aks4896/GalvoInterface/design/block_diagram.pdf

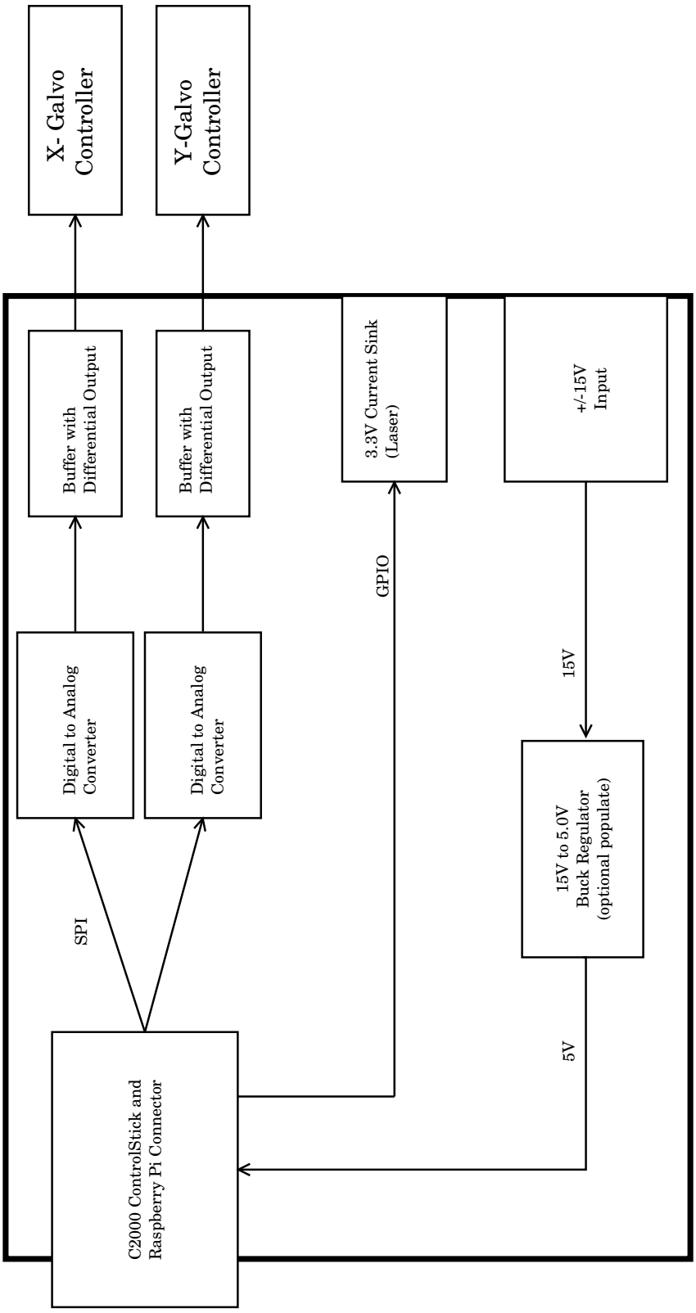
[picture p1: figure]
X- Galvo; Controller; Y-Galvo; Digital to Analog; Converter; Buffer with; Differential Output; C2000 ControlStick and Raspberry Pi Connector; SPI; 3.3V Current Sink; (Laser) GPIO; +/-15V Input; Buck Regulator; (optional populate)

# Differential Output Digital to Analog Converter

Alex Sojda

Galvo Interface Block Diagram V0.1

http://alex.sojda.org/blog
alex.sojda@gmail.com
