aks4896/GalvoInterface/Interface HW.pdf

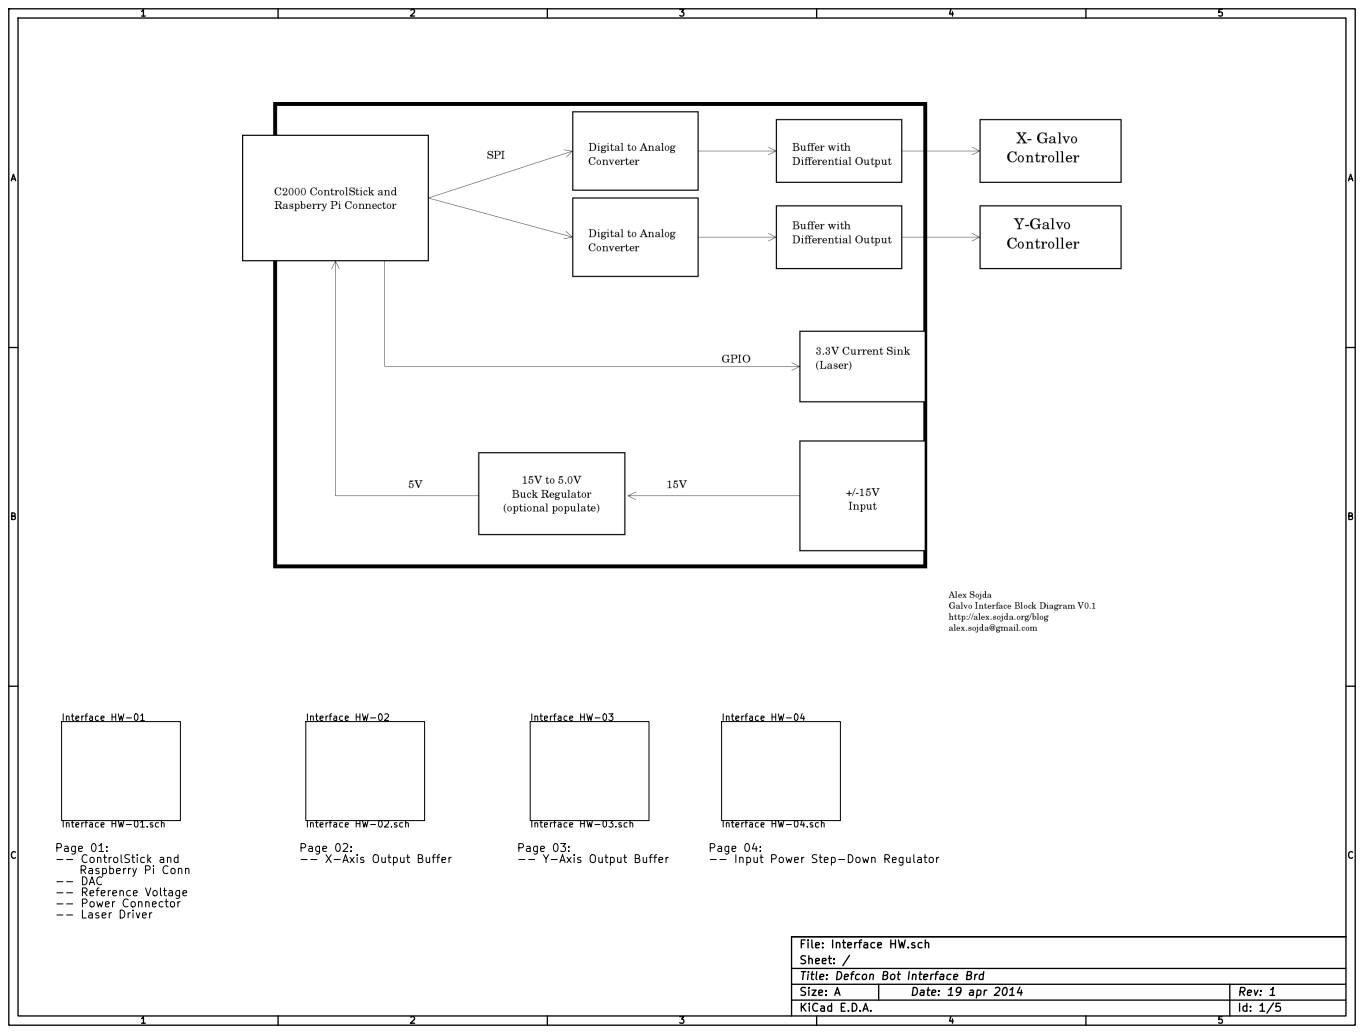
[picture p3: page 1]

Interface HW-03.sch Page 01:

Interface HW-04.sch Page 04:

-- Input Power Step-Down Regulator

Id: 1/5 Title: Defcon Bot Interface Brd File: Interface HW.sch Sheet: /

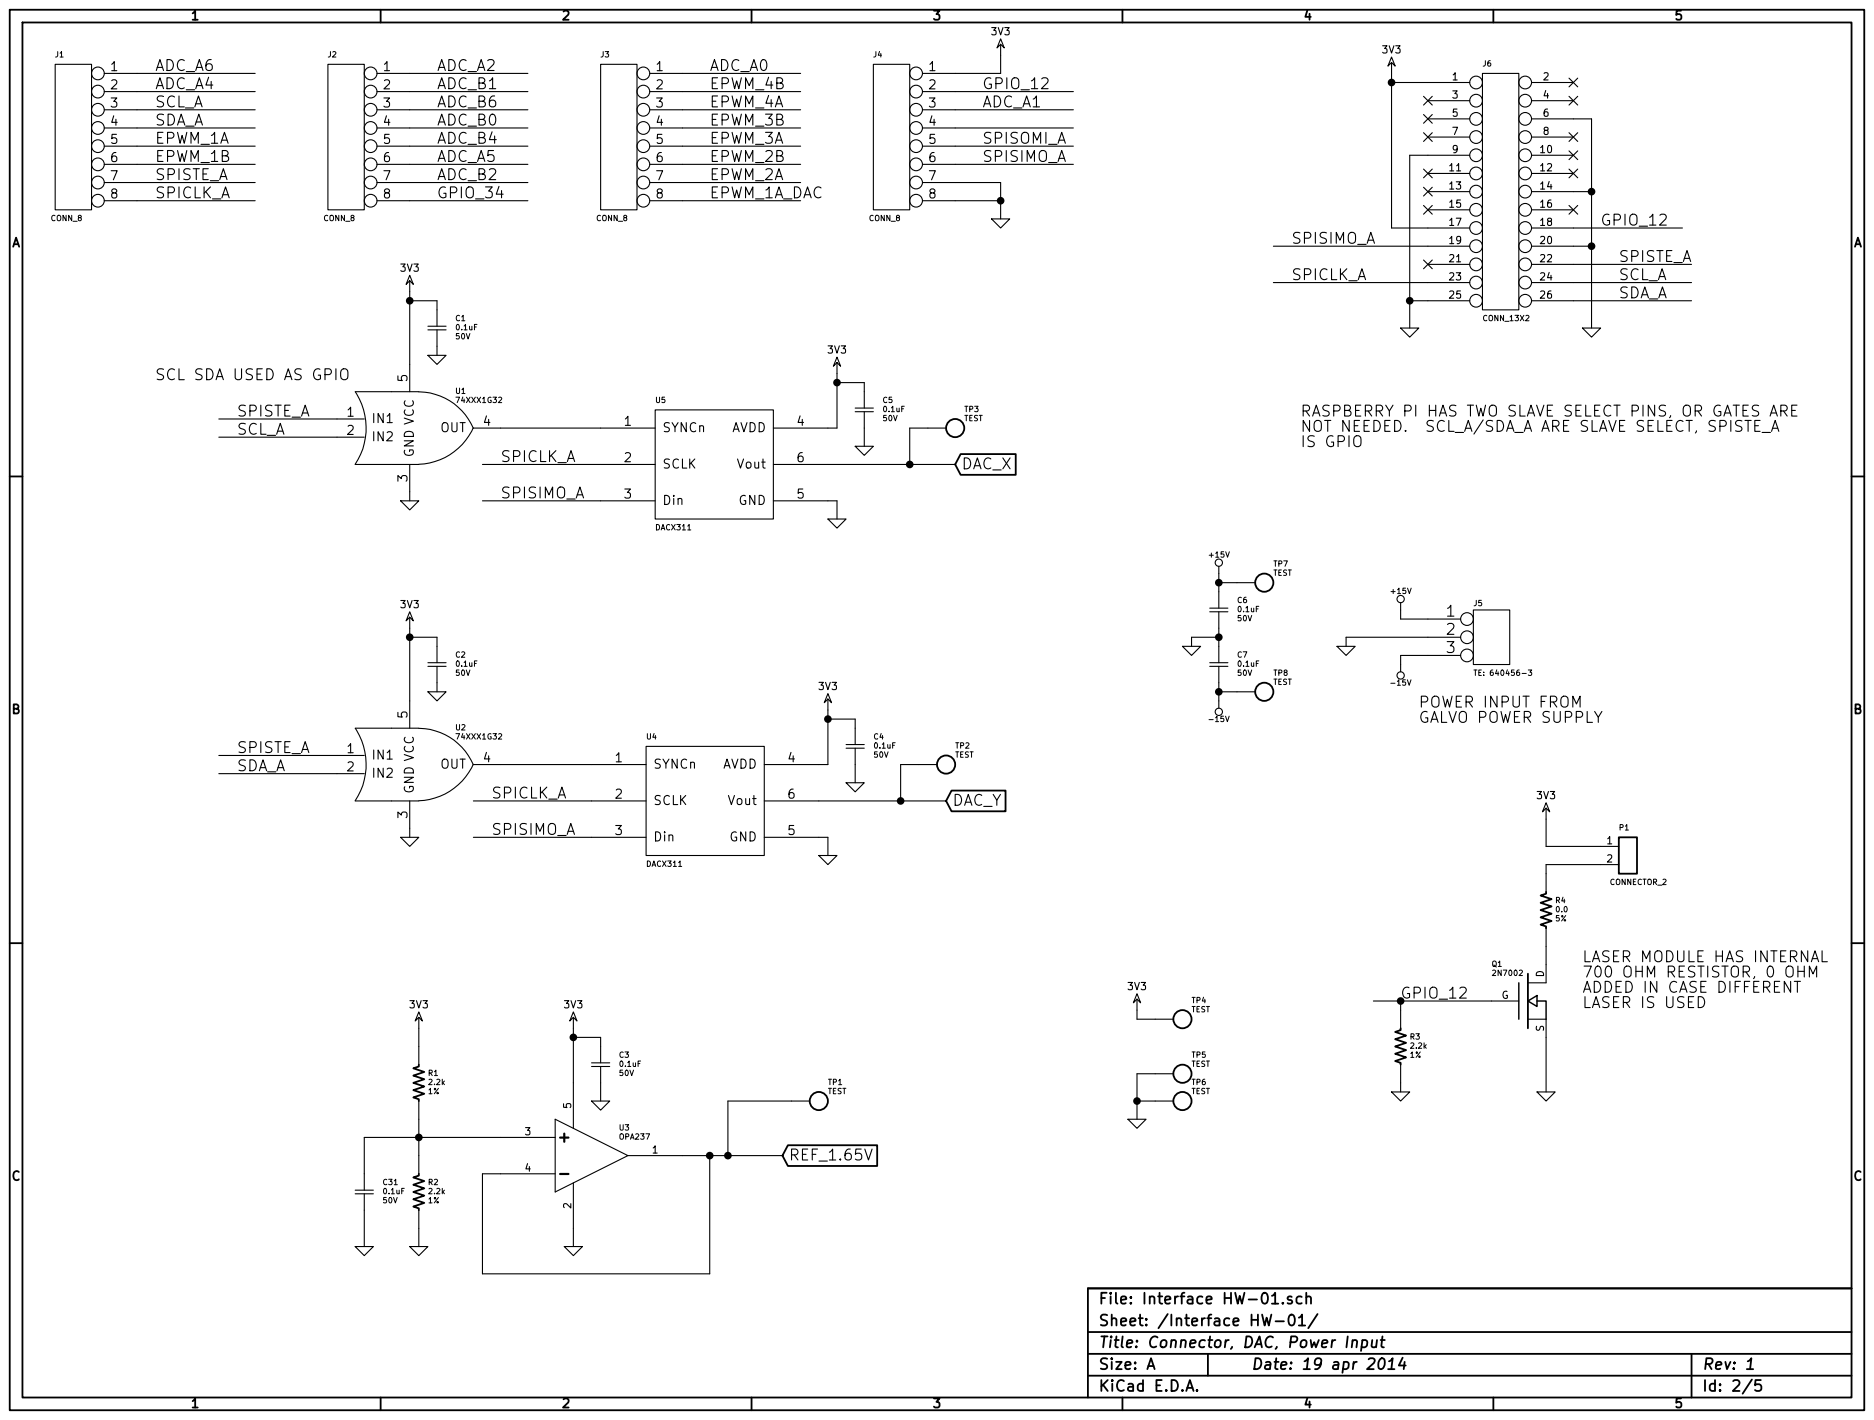
[picture p4: page 2]

SCL SDA USED AS GPIO

RASPBERRY PI HAS TWO SLAVE SELECT PINS, OR GATES ARE
NOT NEEDED. SCL_A/SDA_A ARE SLAVE SELECT, SPISTE_A
IS GPIO

700 OHM RESTISTOR, 0 OHM
ADDED IN CASE DIFFERENT

Title: Connector, DAC, Power Input File: Interface HW-01.sch Sheet: /Interface HW-01/

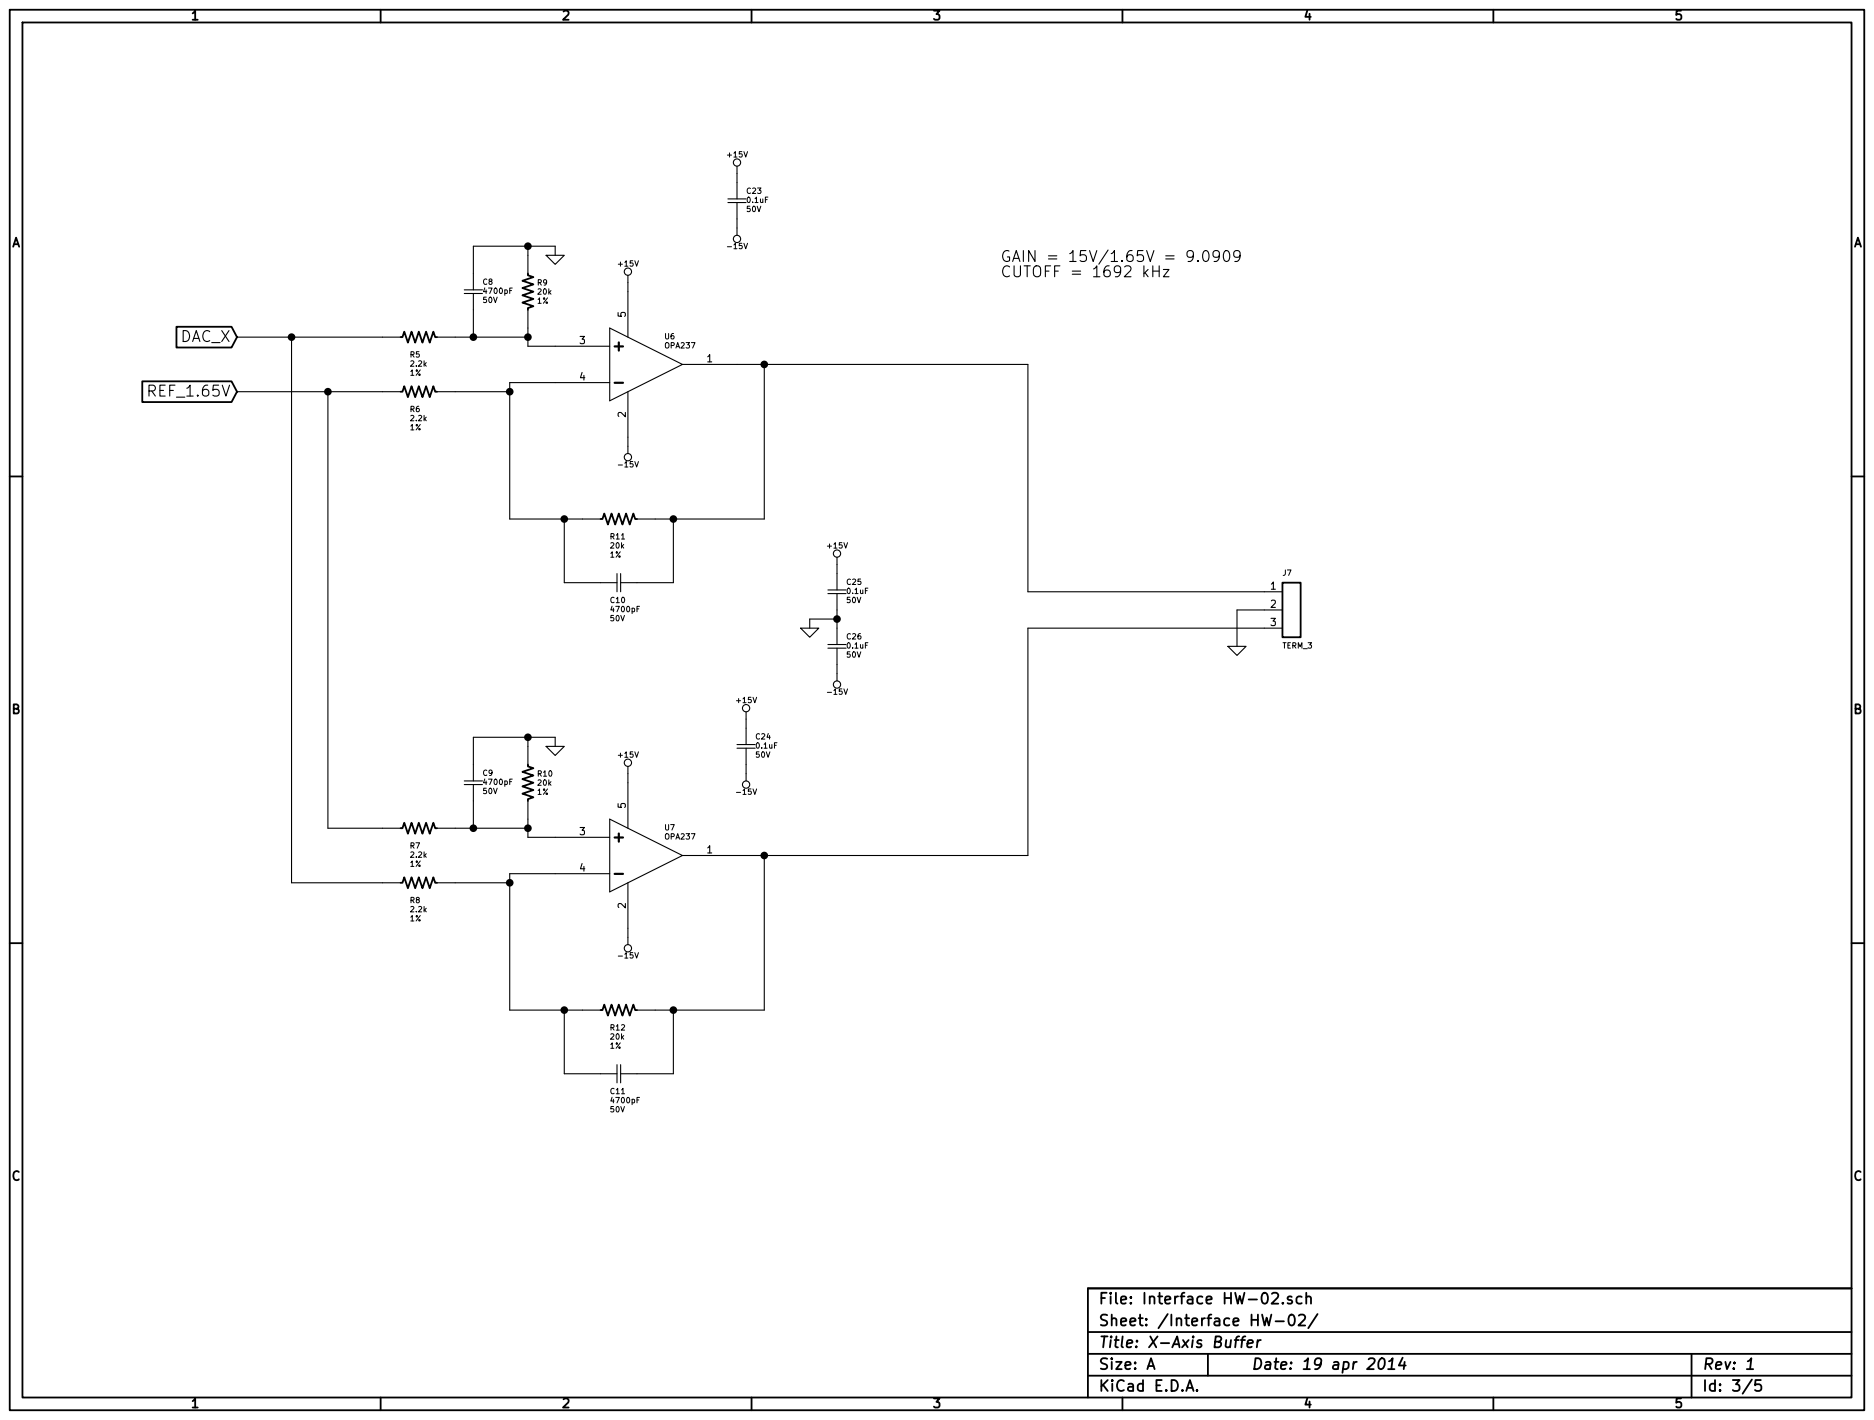
[picture p5: page 3]

Id: 3/5 Title: X-Axis Buffer File: Interface HW-02.sch Sheet: /Interface HW-02/

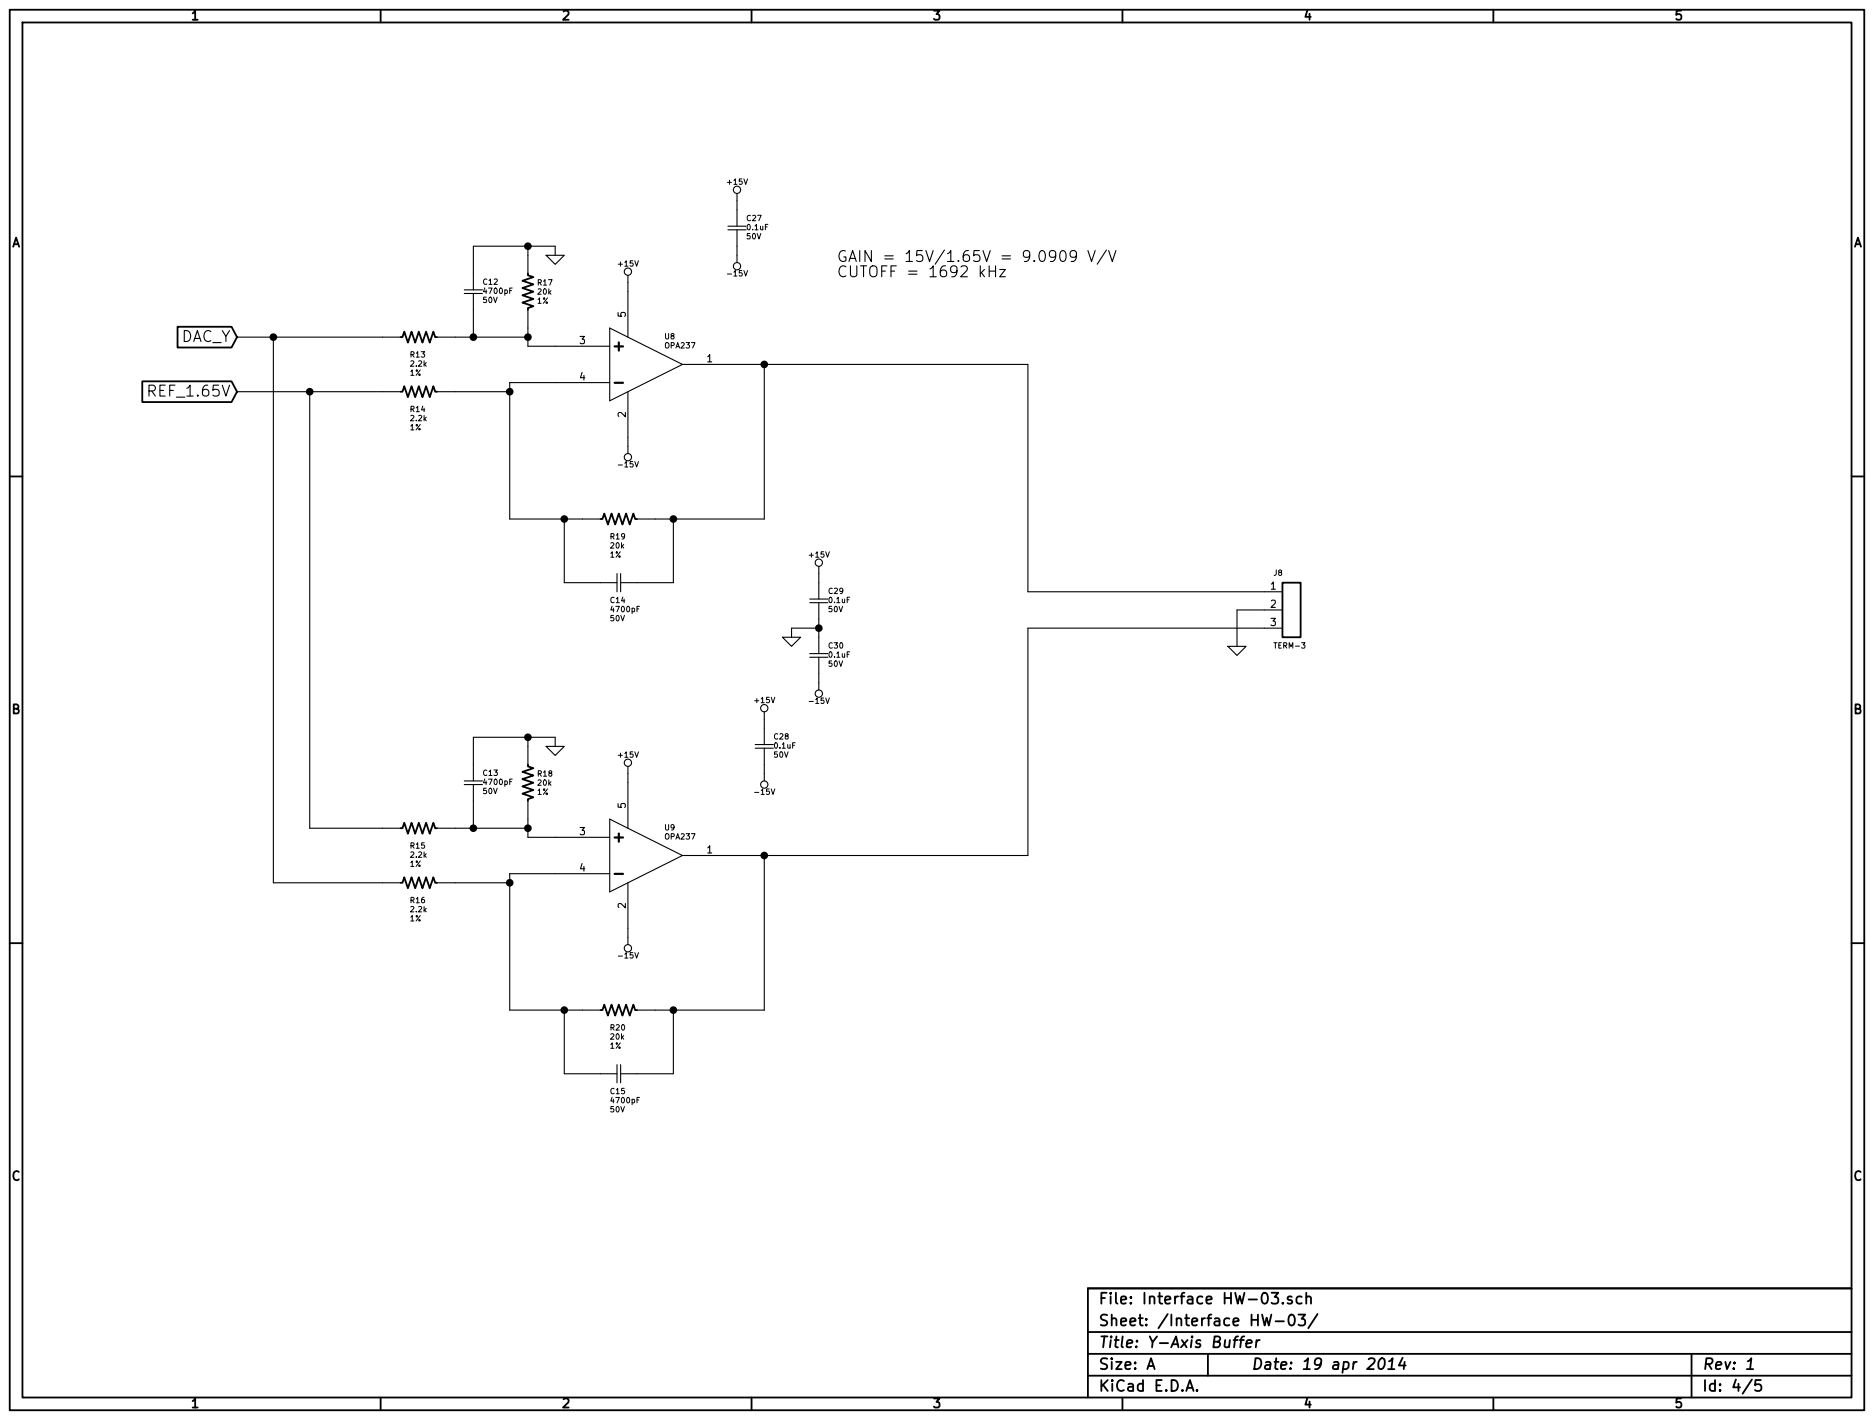
[picture p6: page 4]

Id: 4/5 Title: Y-Axis Buffer File: Interface HW-03.sch Sheet: /Interface HW-03/

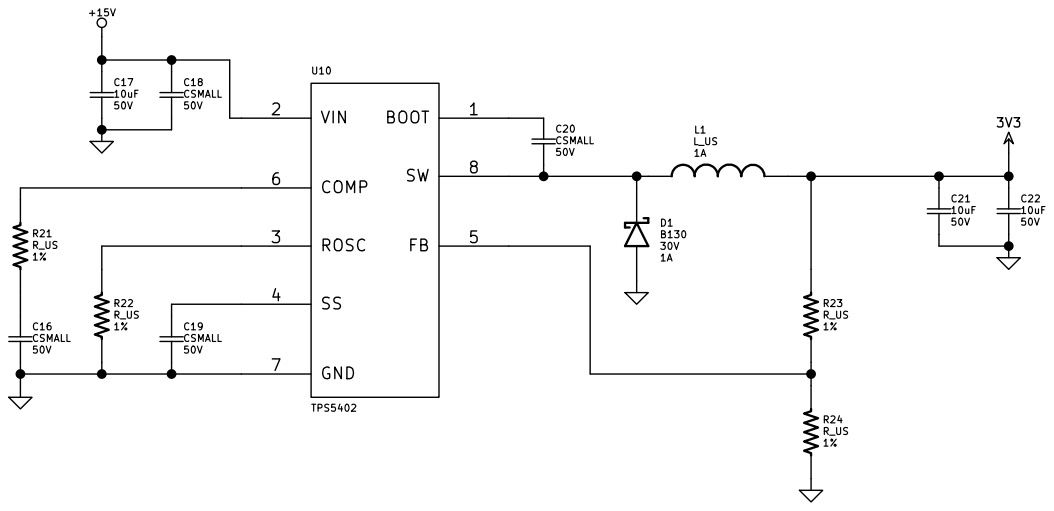
[picture p7: page 5]

Title: Buck Conveter File: Interface HW-04.sch Sheet: /Interface HW-04/
