aks4896/GalvoInterface/ref/TE-640456-3.pdf

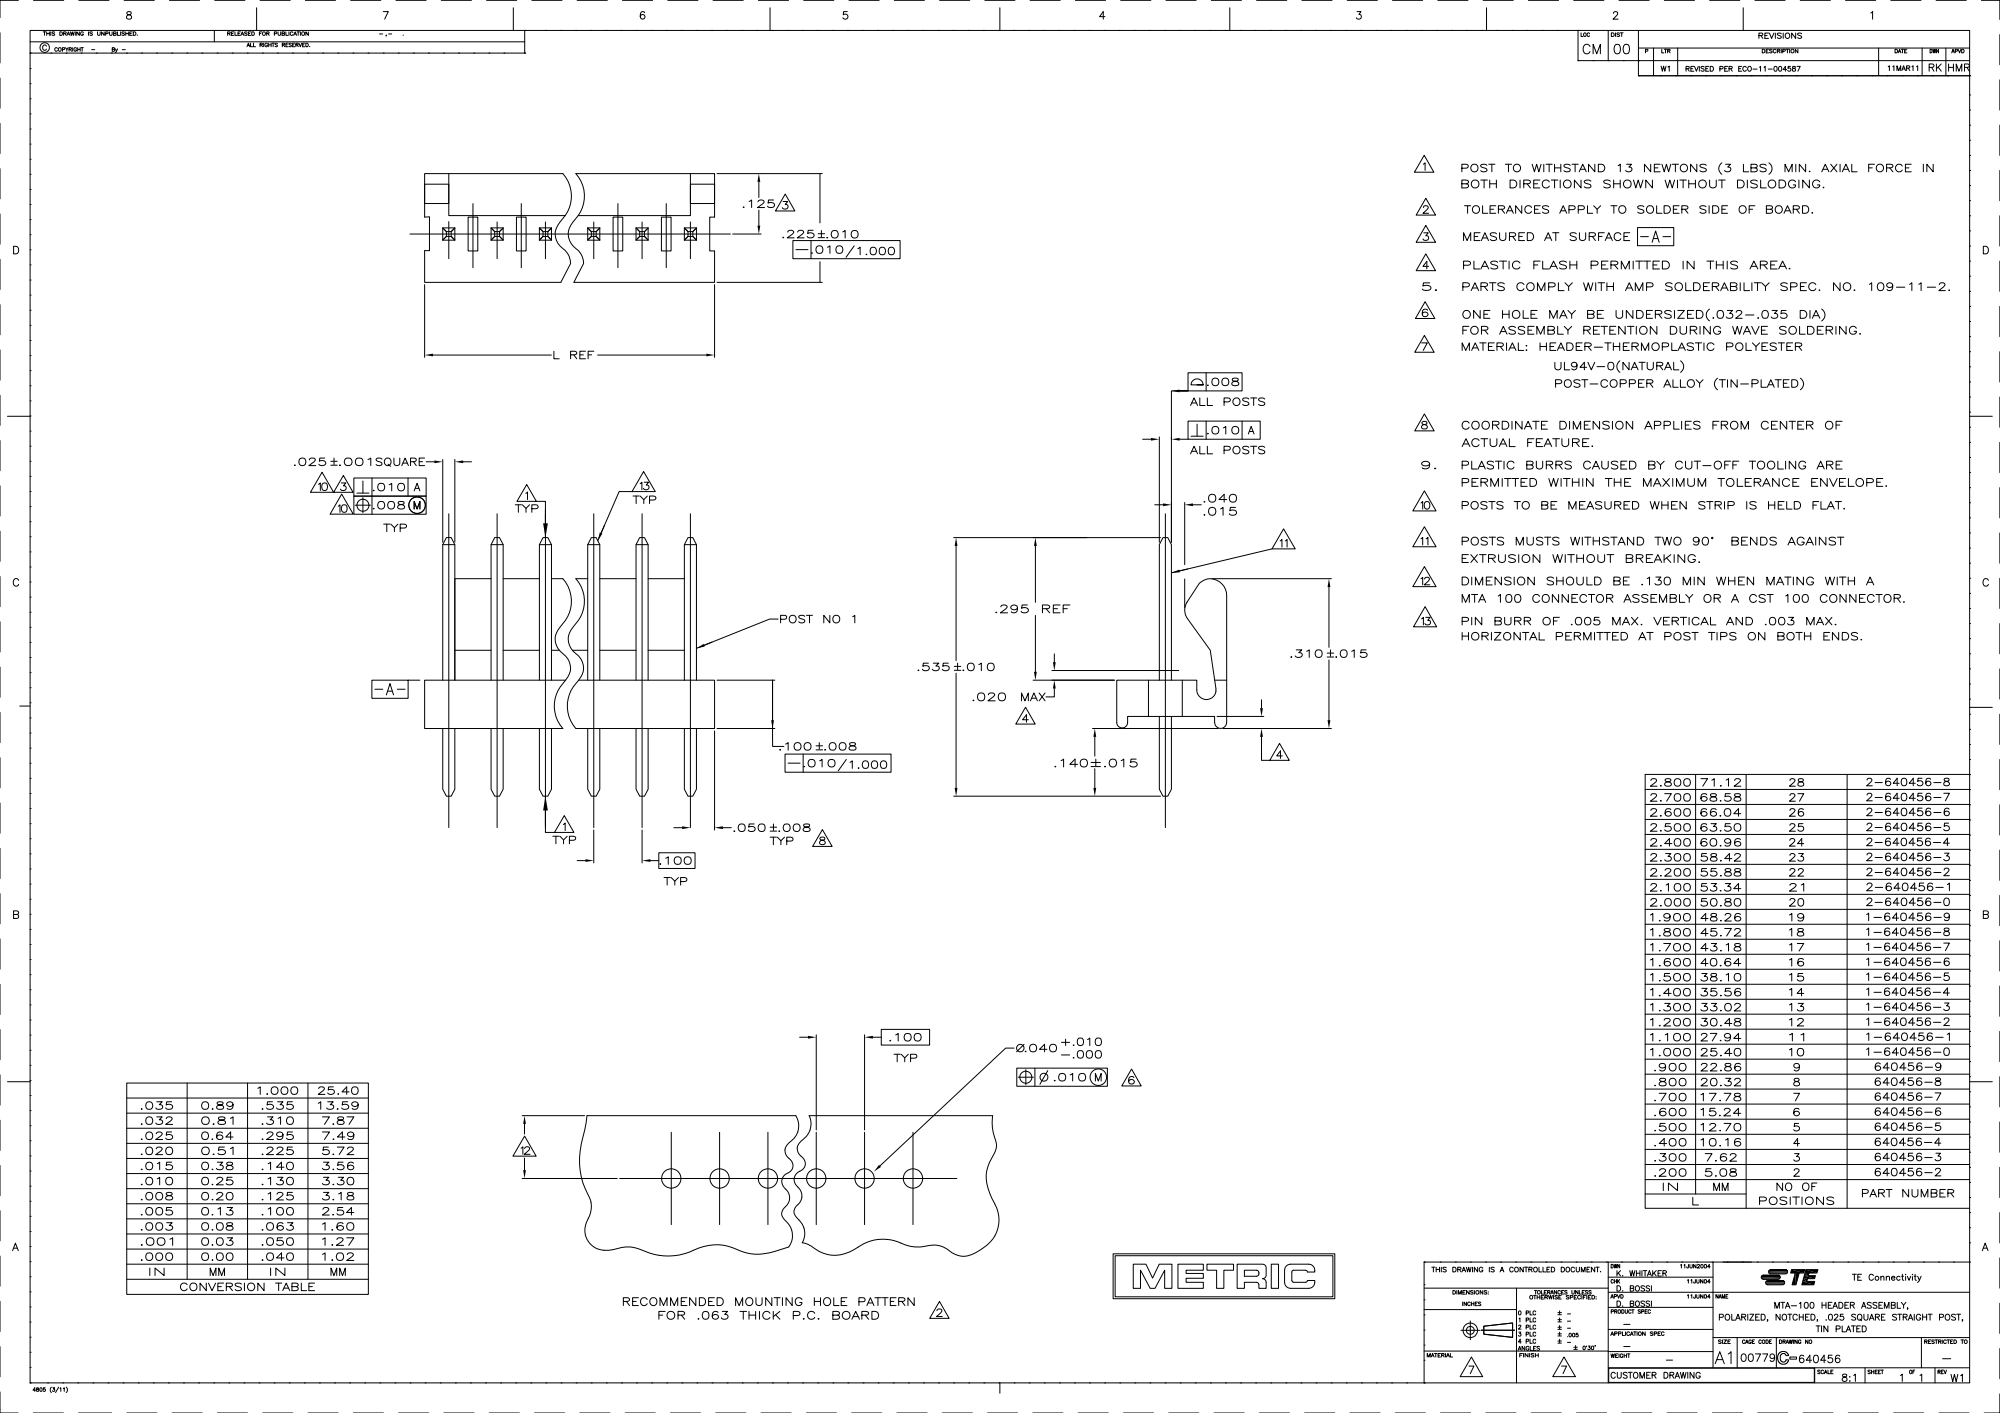
[picture p8: page 1]
