aks4896/GalvoInterface/Interface HW.kicad_pcb

## KiCad design Interface HW.kicad_pcb (2015-10-21)

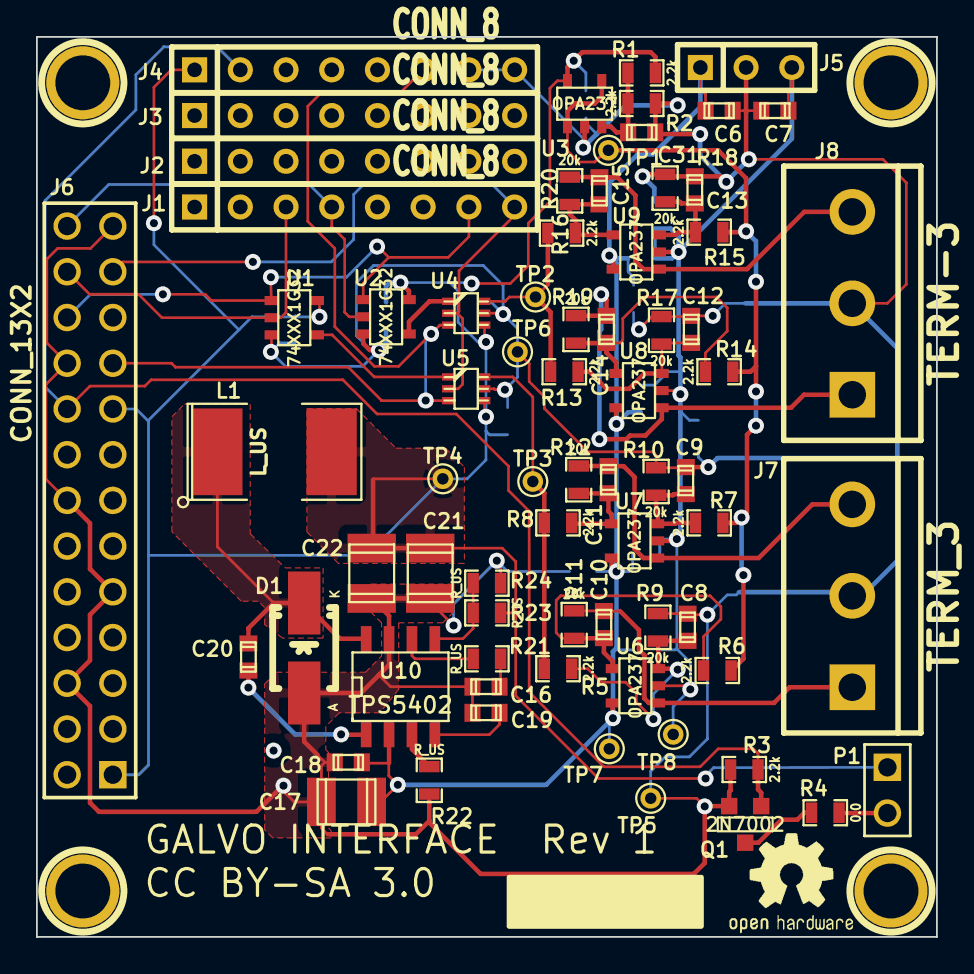
[picture p9: board Interface HW.kicad_pcb from above]

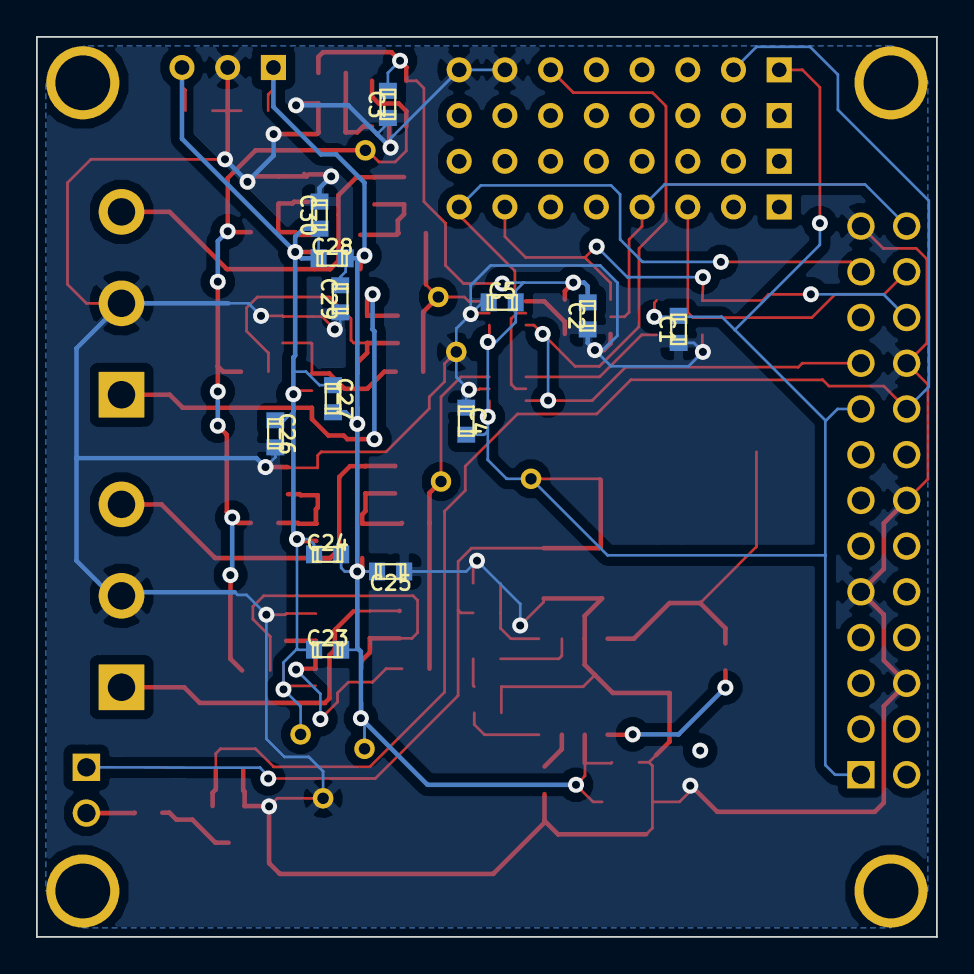
[picture p10: board Interface HW.kicad_pcb from below]

Board: 2 copper layers, 50.0 x 50.0 mm, 89 parts (13 on the bottom side), 37 nets.

Parts:
1PIN, 1PIN#2, 1PIN#3, 1PIN#4: P***; 1pin
C1, C2, C3, C4, C5, C6, C7, C23, C24, C25, C26, C27, C28, C29, C30, C31: 0.1uF; c_0603
C8, C9, C10, C11, C12, C13, C14, C15: 4700pF; c_0603
C16, C18, C19, C20: CSMALL; c_0603
C17, C21, C22: 10uF; c_1210
D1: B130; Diode-SMA
J1, J2, J3, J4: CONN_8; SIL-8
J5: TE: 640456-3; SIL-3
J6: CONN_13X2; pin_array_13x2
J7: TERM_3; bornier3
J8: TERM-3; bornier3
L1: L_US; SM2112L
P1: CONNECTOR_2; PIN_ARRAY_2X1
Q1: 2N7002; SOT23GDS
R1, R2, R3, R5, R6, R7, R8, R13, R14, R15, R16: 2.2k; SM0603_Resistor
R4: 0.0; SM0603_Resistor
R9, R10, R11, R12, R17, R18, R19, R20: 20k; SM0603_Resistor
R21, R22, R23, R24: R_US; SM0603_Resistor
TP1, TP2, TP3, TP4, TP5, TP6, TP7, TP8: TEST; PINTST
U1, U2: 74XXX1G32; SOT23-5
U3, U6, U7, U8, U9: OPA237; SOT23-5
U4, U5: DACX311; sc70-6
U10: TPS5402; SO8E

Connections:
3V3: C1.1, C2.1, C3.1, C4.1, C5.1, C21.1, C22.1, J4.1, J6.1, J6.17, L1.2, P1.1, R1.1, R23.1, TP4.1, U1.5, U2.5, U3.5, U4.4, U5.4
+15V: C6.1, C17.1, C18.1, C23.1, C24.1, C25.1, C27.1, C28.1, C29.1, J5.1, TP7.1, U6.5, U7.5, U8.5, U9.5, U10.2
-15V: C7.2, C23.2, C24.2, C26.2, C27.2, C28.2, C30.2, J5.3, TP8.1, U6.2, U7.2, U8.2, U9.2
/Interface HW-01/GPIO_12: J4.2, J6.18, Q1.G, R3.1
/Interface HW-01/SCL_A: J1.3, J6.24, U1.2
/Interface HW-01/SDA_A: J1.4, J6.26, U2.2
/Interface HW-01/SPICLK_A: J1.8, J6.23, U4.2, U5.2
/Interface HW-01/SPISIMO_A: J4.6, J6.19, U4.3, U5.3
/Interface HW-01/SPISTE_A: J1.7, J6.22, U1.1, U2.1
DAC_X: R5.2, R8.2, TP3.1, U5.6
DAC_Y: R13.2, R16.2, TP2.1, U4.6
GND: C1.2, C2.2, C3.2, C4.2, C5.2, C6.2, C7.1, C8.1, C9.1, C12.1, C13.1, C16.2, C17.2, C18.2, C19.2, C21.2, C22.2, C25.2, C26.1, C29.2, C30.1, C31.2, D1.1, J4.7, J4.8, J5.2, J6.6, J6.9, J6.14, J6.20, J6.25, J7.2, J8.2, Q1.S, R2.2, R3.2, R9.2, R10.2, R17.2, R18.2, R22.2, R24.2, TP5.1, TP6.1, U1.3, U2.3, U3.2, U4.5, U5.5, U10.7
unnamed: U1.4, U5.1
unnamed: Q1.D, R4.2
unnamed: P1.2, R4.1
unnamed: U2.4, U4.1
unnamed: C31.1, R1.2, R2.1, U3.3
unnamed: C11.1, J7.3, R12.1, U7.1
unnamed: C9.2, R7.1, R10.1, U7.3
unnamed: C8.2, R5.1, R9.1, U6.3
unnamed: C11.2, R8.1, R12.2, U7.4
unnamed: C10.2, R6.1, R11.2, U6.4
unnamed: C10.1, J7.1, R11.1, U6.1
unnamed: C15.1, J8.3, R20.1, U9.1
unnamed: C13.2, R15.1, R18.1, U9.3
unnamed: C12.2, R13.1, R17.1, U8.3
unnamed: C15.2, R16.1, R20.2, U9.4
unnamed: C14.2, R14.1, R19.2, U8.4
unnamed: C14.1, J8.1, R19.1, U8.1
unnamed: C20.1, U10.1
unnamed: C20.2, D1.2, L1.1, U10.8
unnamed: R23.2, R24.1, U10.5
unnamed: R21.1, U10.6
unnamed: R22.1, U10.3
unnamed: C19.1, U10.4
unnamed: C16.1, R21.2
REF_1.65V: R6.2, R7.2, R14.2, R15.2, TP1.1, U3.1, U3.4
