aks4896/GalvoInterface/todo.txt

Rename Slave-select pins to reflect how they are differnt for raspberry
	pi and ControlStick
