aks4896/GalvoInterface/(commit log)

2014-03-11 Added initial files
    [Interface HW.sch]
2014-03-11 Added schematic and pinout of controlstick
2014-03-11 Completed pinout of controlStick
    [Interface HW.sch]
2014-03-11 Added op-amp, and op-amp datasheet
    [Interface HW.sch]
2014-03-11 Added resistor symbol
    [Interface HW.sch]
2014-03-12 Added diff-amp circuit to schematic
    [Interface HW.sch]
2014-03-26 Added SPI TRM for F28027 (same for F28069), and OR gate datasheet
2014-03-26 Changed analog circuit to be differential output
    [Interface HW.sch]
2014-03-30 commit before attempting to add 2nd and 3rd page
    [Interface HW pg02.sch, Interface HW.sch, noname.sch]
2014-04-01 Intermediate commit so I can split up the schematic
2014-04-01 Working on adding new page, intermediate commit
    [Interface HW-01.sch]
2014-04-02 Added connector drawing and block diagram png
2014-04-02 Still working
    [Interface HW pg02.sch, Interface HW-01.sch, Interface HW-02.sch, Interface HW.sch]
2014-04-02 added new page for Y axis
    [Interface HW-01.sch, Interface HW-03.sch, Interface HW.sch]
2014-04-05 Modified schematic, added laser driver and page for buck converter
    [Interface HW-01.sch, Interface HW-02.sch, Interface HW-03.sch, Interface HW-04.sch, Interface HW.sch]
2014-04-05 added buck converter datasheet
2014-04-05 Added buck converter to schematic, almost done
    [Interface HW-04.sch]
2014-04-05 Schematic before assigning ref des and netlisting
    [Interface HW-01.sch, Interface HW-02.sch, Interface HW-03.sch, Interface HW-04.sch]
2014-04-09 Started layout
    [Interface HW-01.sch, Interface HW-02.sch, Interface HW-03.sch, Interface HW-04.sch, Interface HW.kicad_pcb, Interface HW.sch]
2014-04-16 Changed PCB size to 5x5cm, got most components placed
    [Interface HW.kicad_pcb]
2014-04-16 Added a cap to ref, chages buck converter caps, more routing, didn't pull in netlist
    [Interface HW-01.sch, Interface HW-02.sch, Interface HW-03.sch, Interface HW-04.sch, Interface HW.kicad_pcb, Interface HW.sch]
2014-04-16 More routing, added power supply test points, added mounting holes
    [Interface HW-01.sch, Interface HW-02.sch, Interface HW-03.sch, Interface HW-04.sch, Interface HW.kicad_pcb]
2014-04-23 no unconnected PINSgit status git status
    [Interface HW-01.sch, Interface HW-02.sch, Interface HW-03.sch, Interface HW-04.sch, Interface HW.kicad_pcb, Interface HW.sch]
2014-04-23 Silk cleanup
    [Interface HW.kicad_pcb]
2014-04-23 Added OSHW logo
    [Interface HW.kicad_pcb]
2015-10-20 Updated schematic
    [Interface HW.kicad_pcb]
2015-10-20 Removed unused temp files
    [noname.sch]
2015-10-20 Corrected note about bandwidth of amp circuit
    [Interface HW-01.sch, Interface HW-02.sch, Interface HW-03.sch, Interface HW-04.sch, Interface HW.sch]
2015-10-21 Created gerber files for release
    [Interface HW.kicad_pcb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]
2015-10-22 2nd try submitting files, board outline added
    [Interface HW-B_Cu.gbl, Interface HW-B_Mask.gbs, Interface HW-B_SilkS.gbo, Interface HW-Edge_Cuts.gbr, Interface HW-F_Cu.gtl, Interface HW-F_Mask.gts, Interface HW-F_SilkS.gto]
