aks4896/GalvoInterface/(notices)

Notices in the files:
Interface HW.kicad_pcb:
CC BY-SA 3.0
